mpflaga/biofeedback_2560_3V-eagle/biofeedback_2560_3V.pdf

# GND0.1uF

# 0R00.1uF

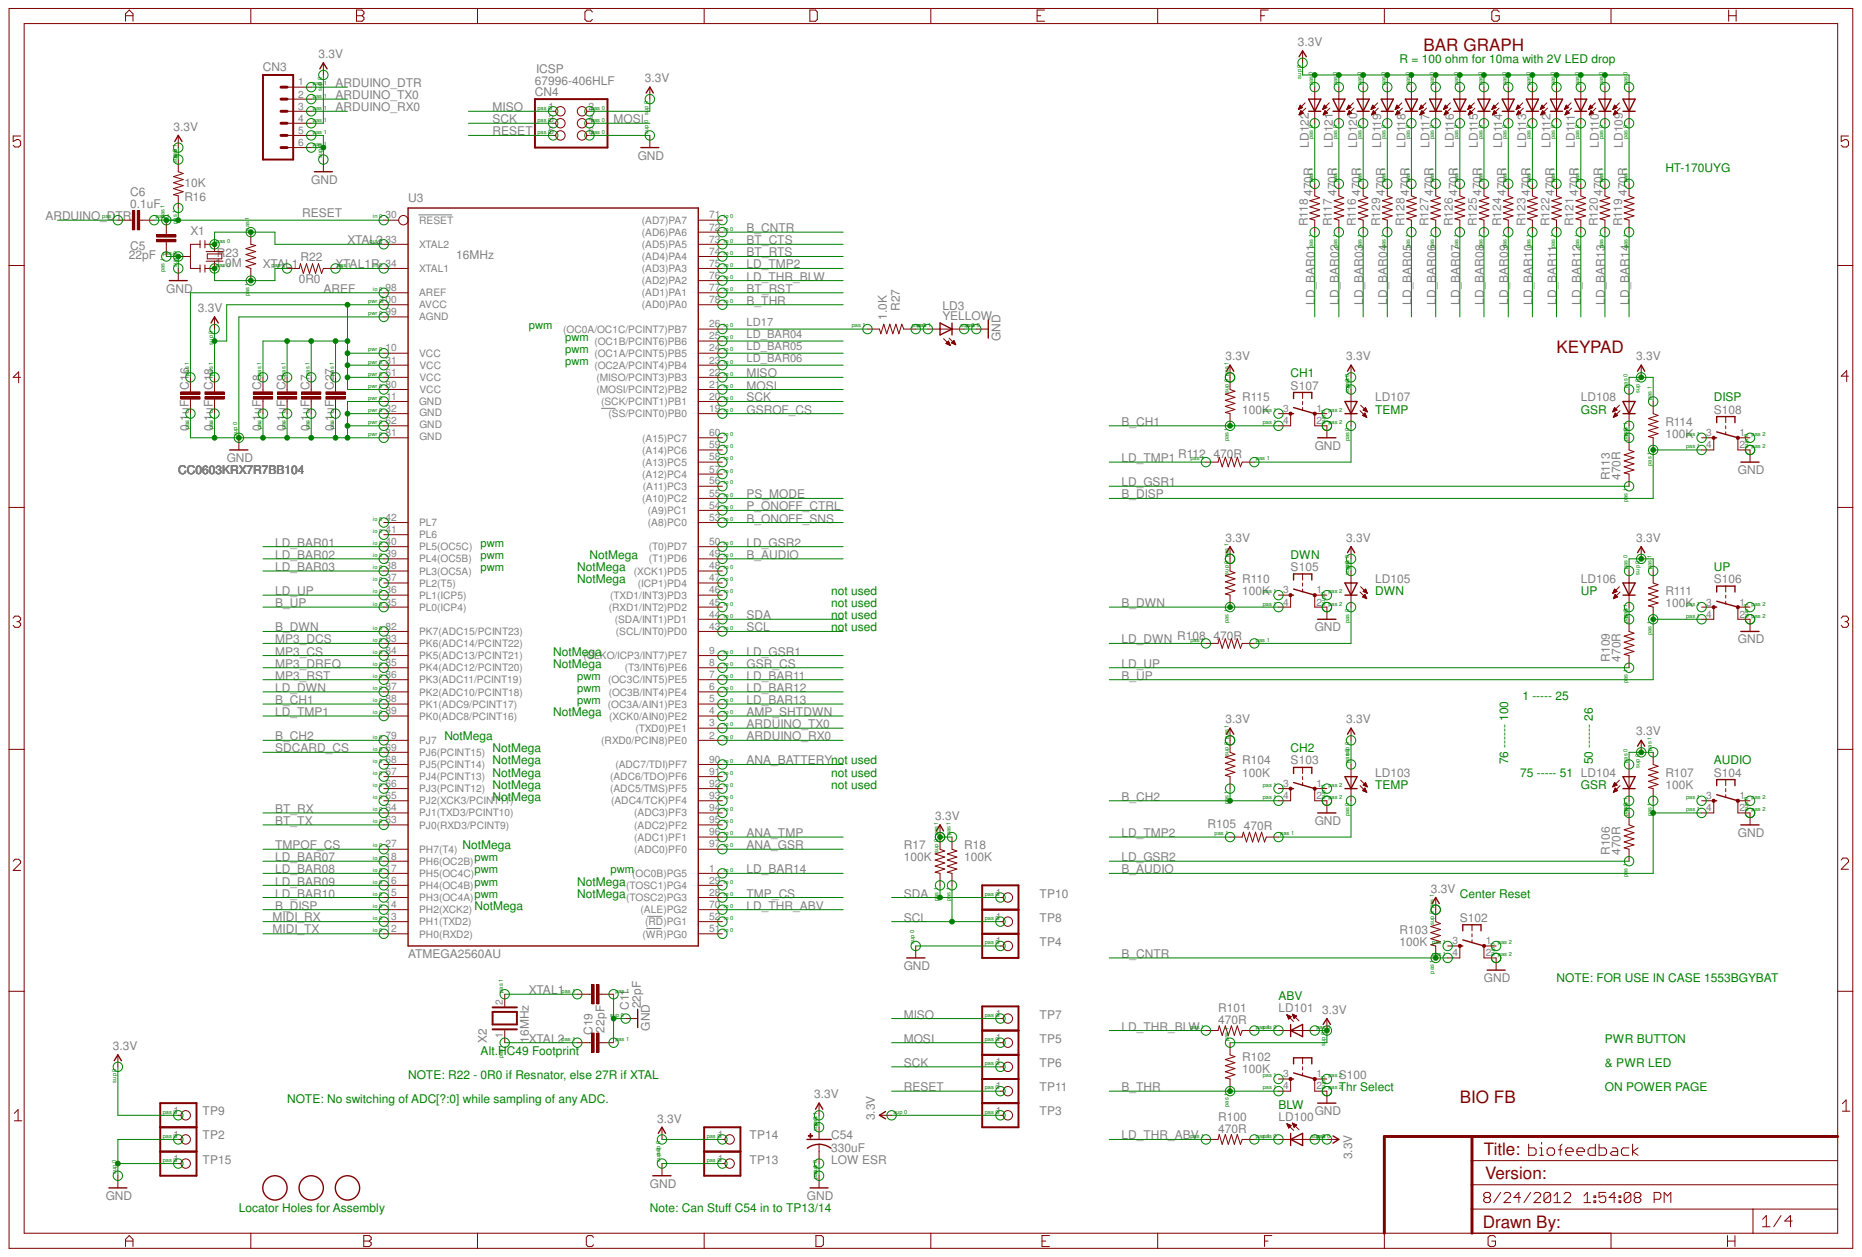
[picture p1: page 1]

BAR GRAPH
R = 100 ohm for 10ma with 2V LED drop

pas 0 pas 0 pas 1 pas 1

pwr 0 | AGND 99

pwr 0 | VCC 10

pas 1 pas 1 pas 1 pas 1

pas 1 pas 1

NOTE: FOR USE IN CASE 1553BGYBAT

NOTE: R22 - 0R0 if Resnator, else 27R if XTAL

NOTE: No switching of ADC[?:0] while sampling of any ADC.

Locator Holes for Assembly

Note: Can Stuff C54 in to TP13/14

## AUDIO AMPLIFIER

## LINE INPUT

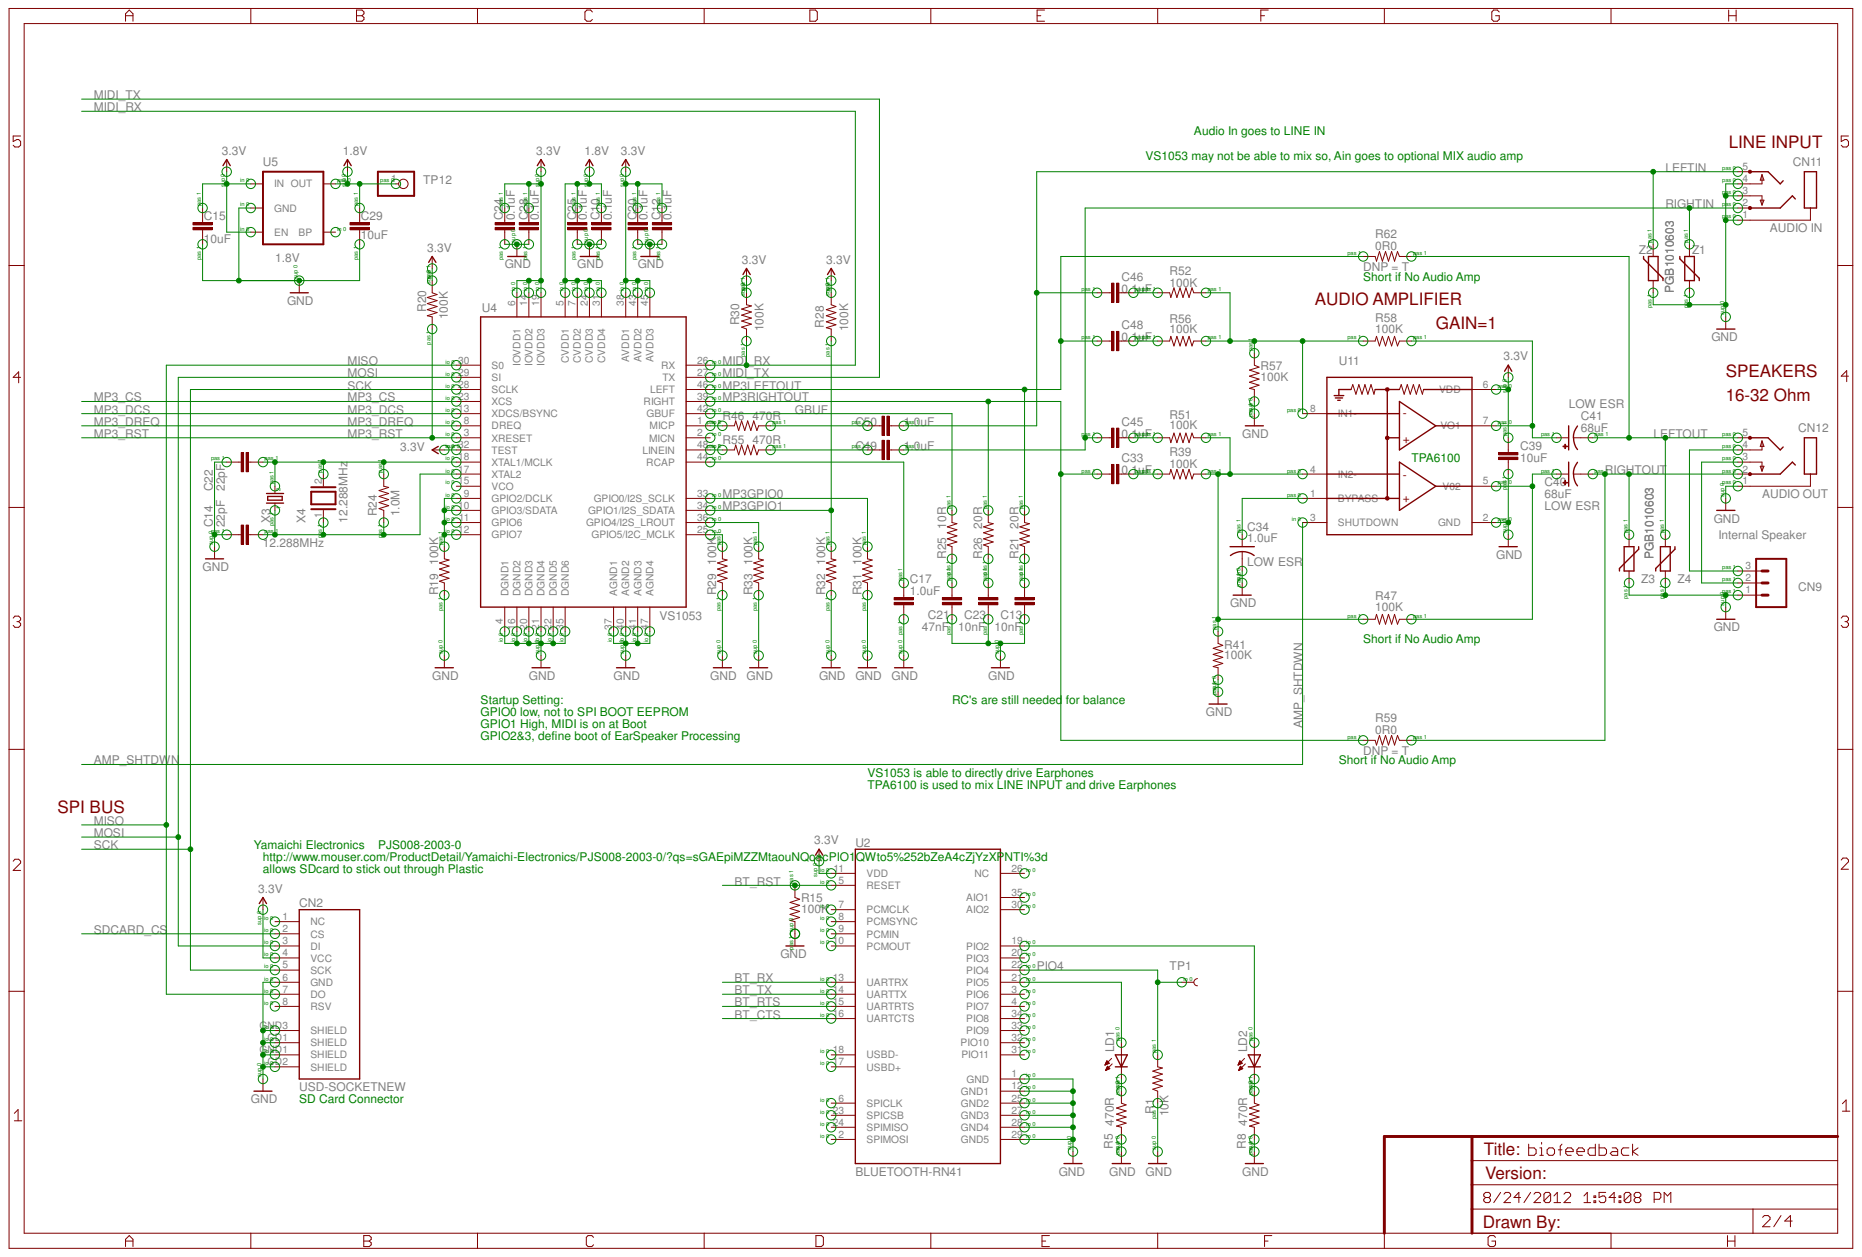
[picture p2: page 2]

Audio In goes to LINE IN

VS1053 may not be able to mix so, Ain goes to optional MIX audio amp

Short if No Audio Amp

Startup Setting:
GPIO0 low, not to SPI BOOT EEPROM
GPIO1 High, MIDI is on at Boot
GPIO2&3, define boot of EarSpeaker Processing

RC's are still needed for balance

VS1053 is able to directly drive Earphones
TPA6100 is used to mix LINE INPUT and drive Earphones

Yamaichi Electronics PJS008-2003-0
http://www.mouser.com/ProductDetail/Yamaichi-Electronics/PJS008-2003-0/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
allows SDcard to stick out through Plastic

## EXTERNAL

## GSR RESISTANCE

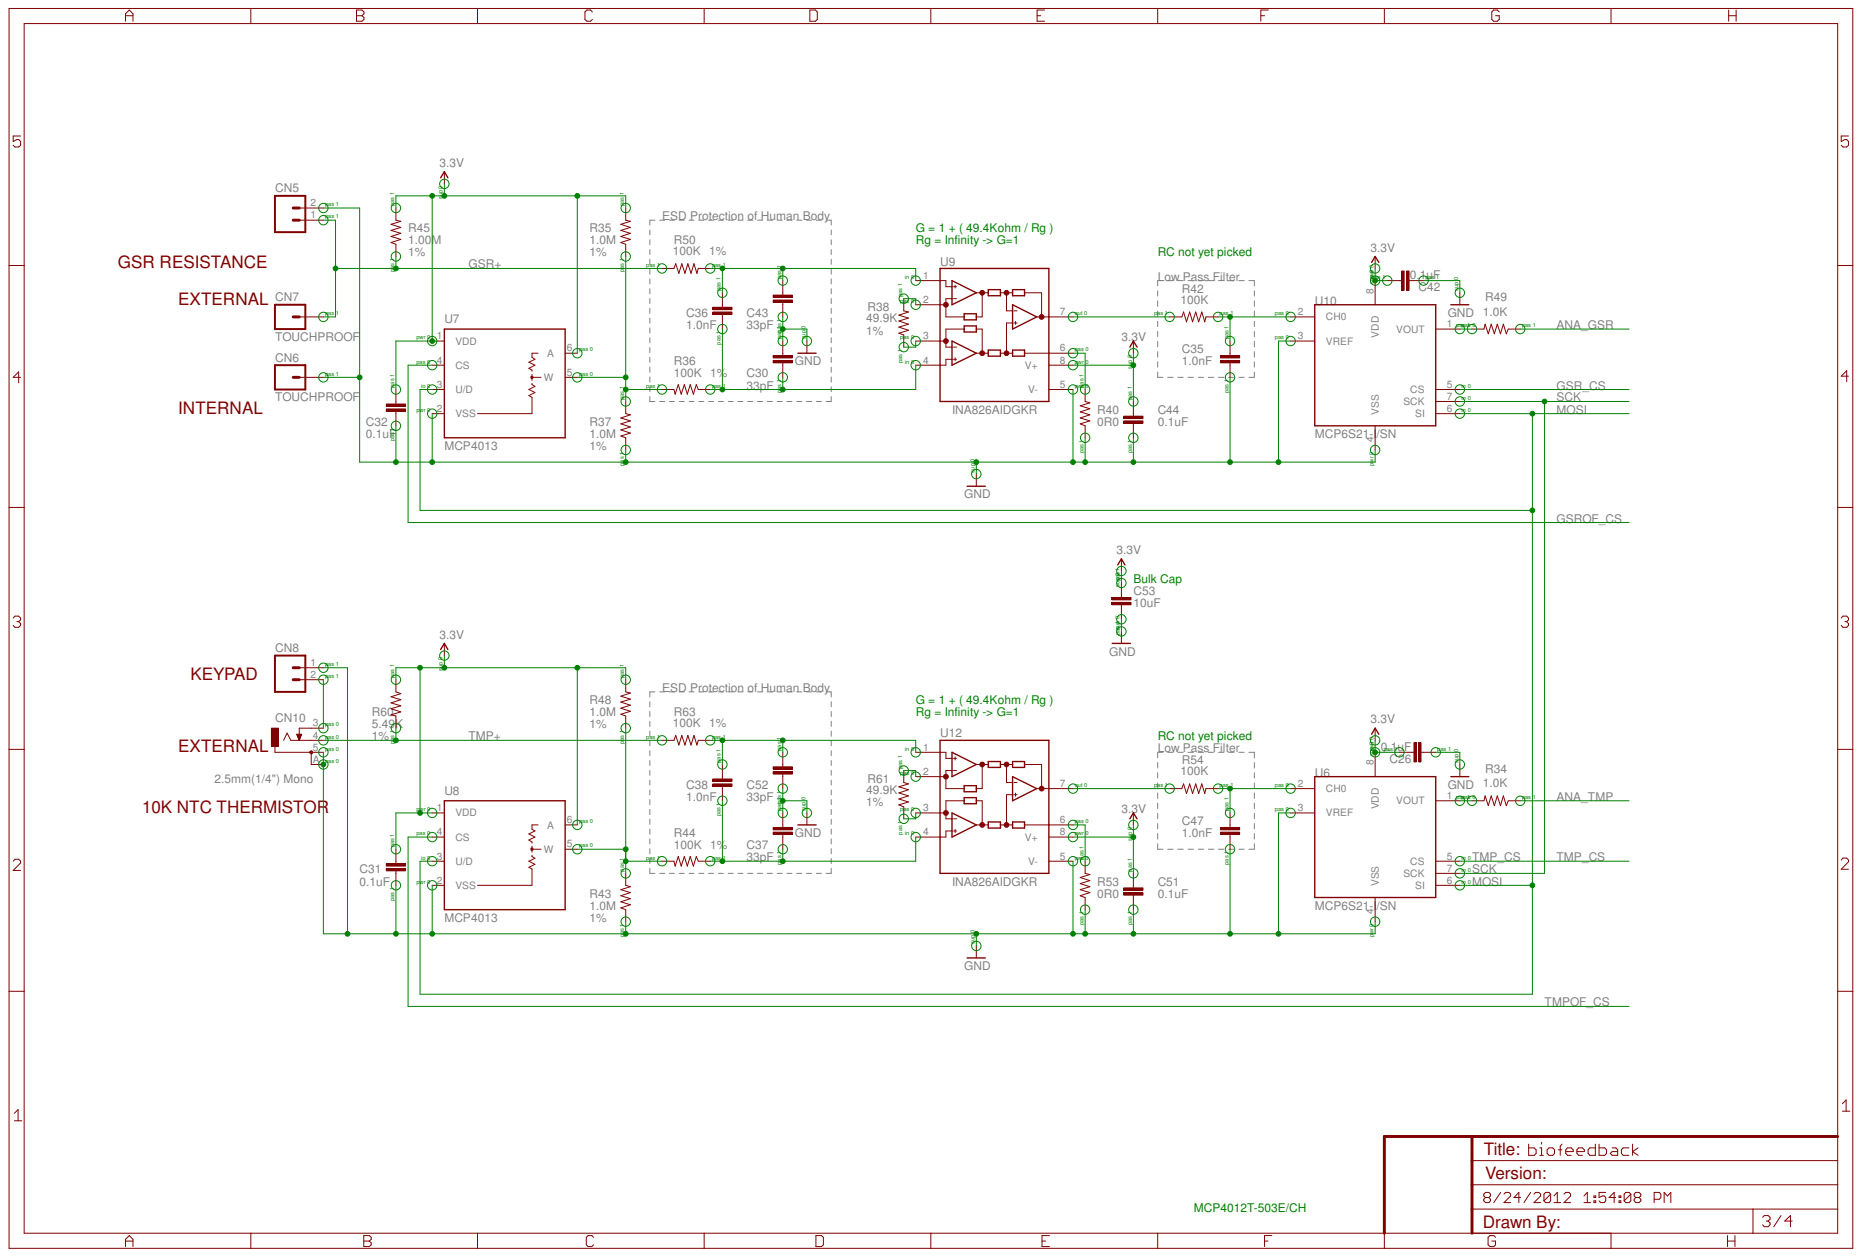
[picture p3: page 3]

pas 1 pas 1

ESD Protection of Human Body

RC not yet picked

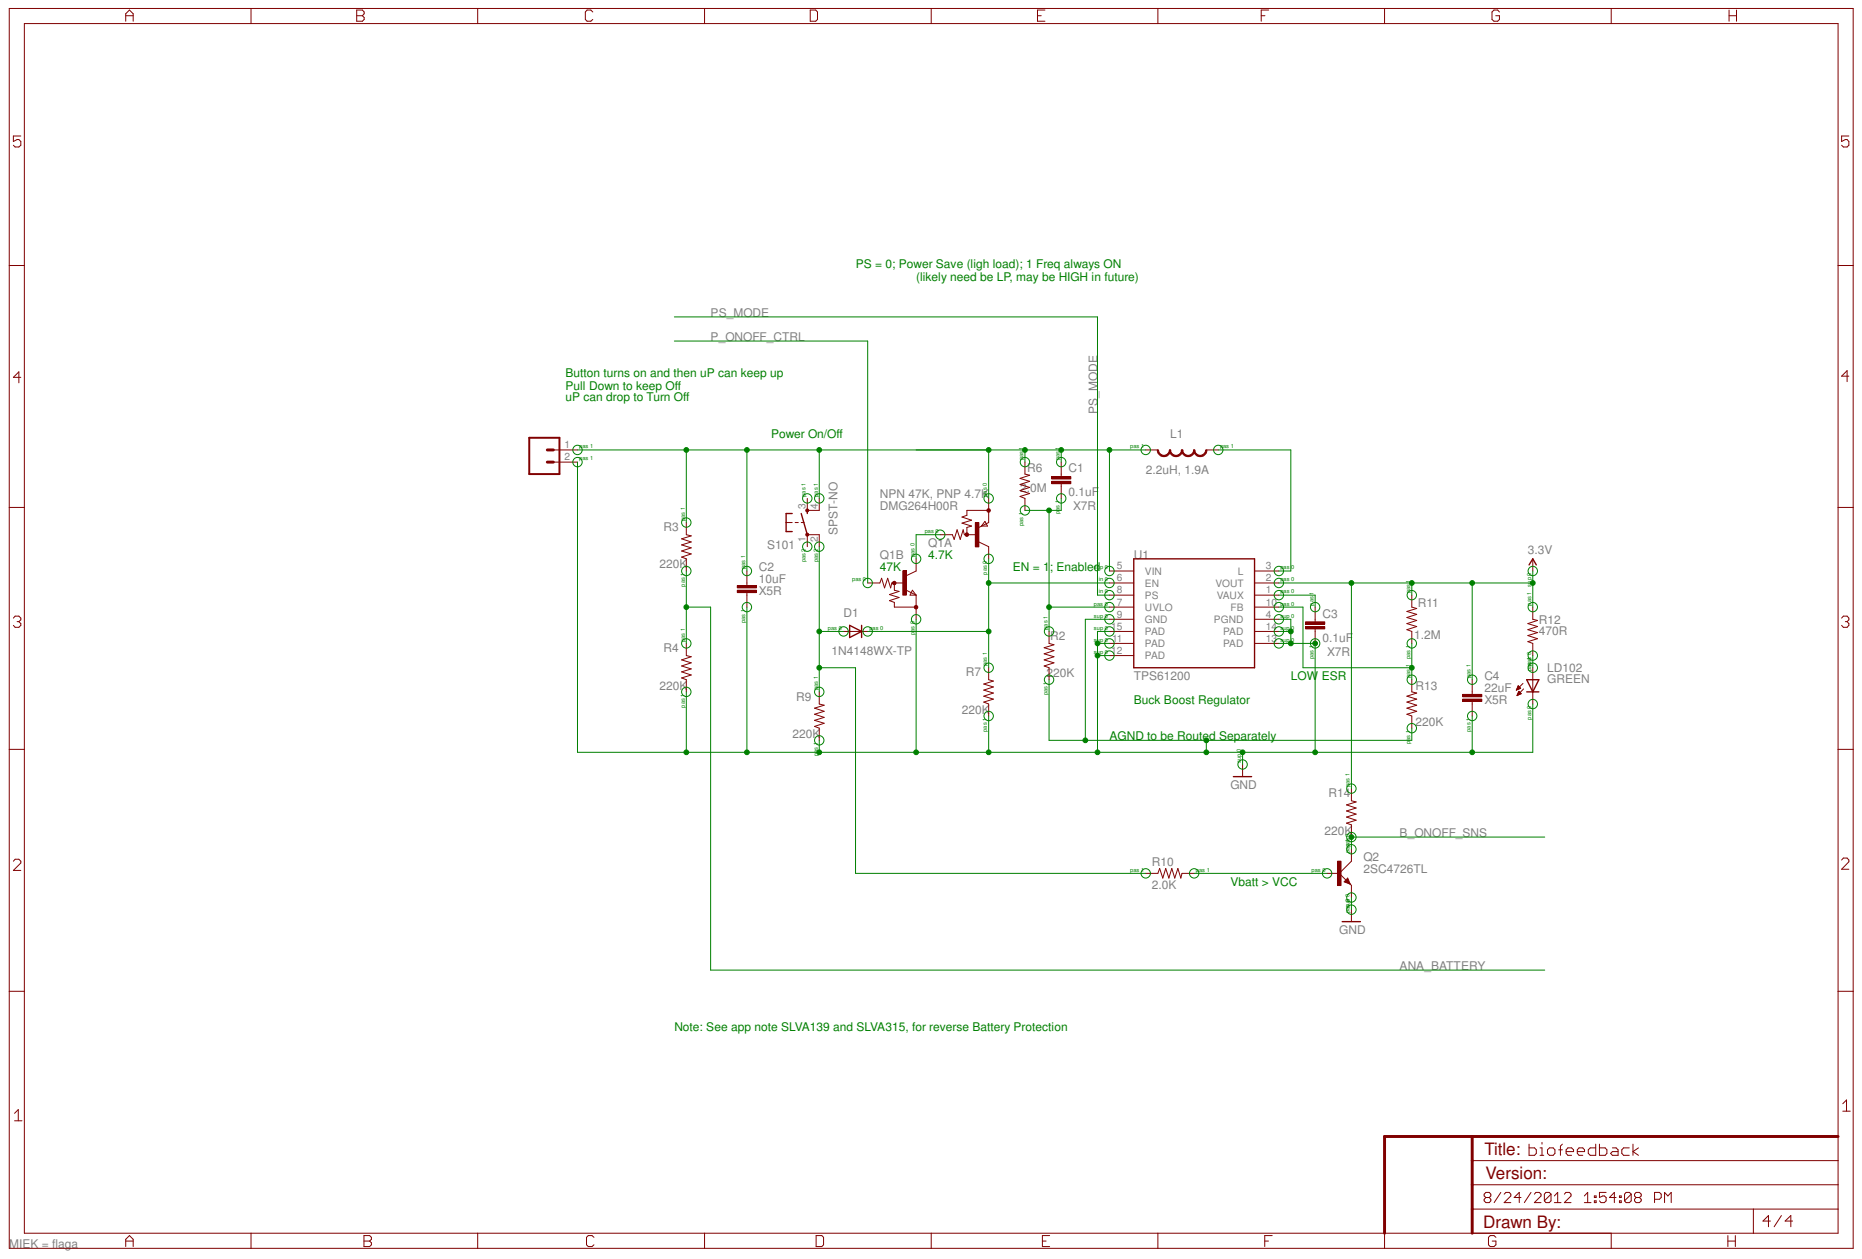
[picture p4: page 4]

PS = 0; Power Save (ligh load); 1 Freq always ON

(likely need be LP, may be HIGH in future)

Button turns on and then uP can keep up
Pull Down to keep Off
uP can drop to Turn Off

pas 1 pas 1

sup 0 | GND 9 | sup 0
sup 0 | PAD 15 | sup 0
sup 0 | PAD 11 | sup 0

AGND to be Routed Separately

pas 0 pas 0 sup 0 pas 1 pas 1

Note: See app note SLVA139 and SLVA315, for reverse Battery Protection
