mpflaga/biofeedback_2560_3V-eagle/biofeedback_2560_3V.brd

## EAGLE design biofeedback_2560_3V.brd (2012-07-17)

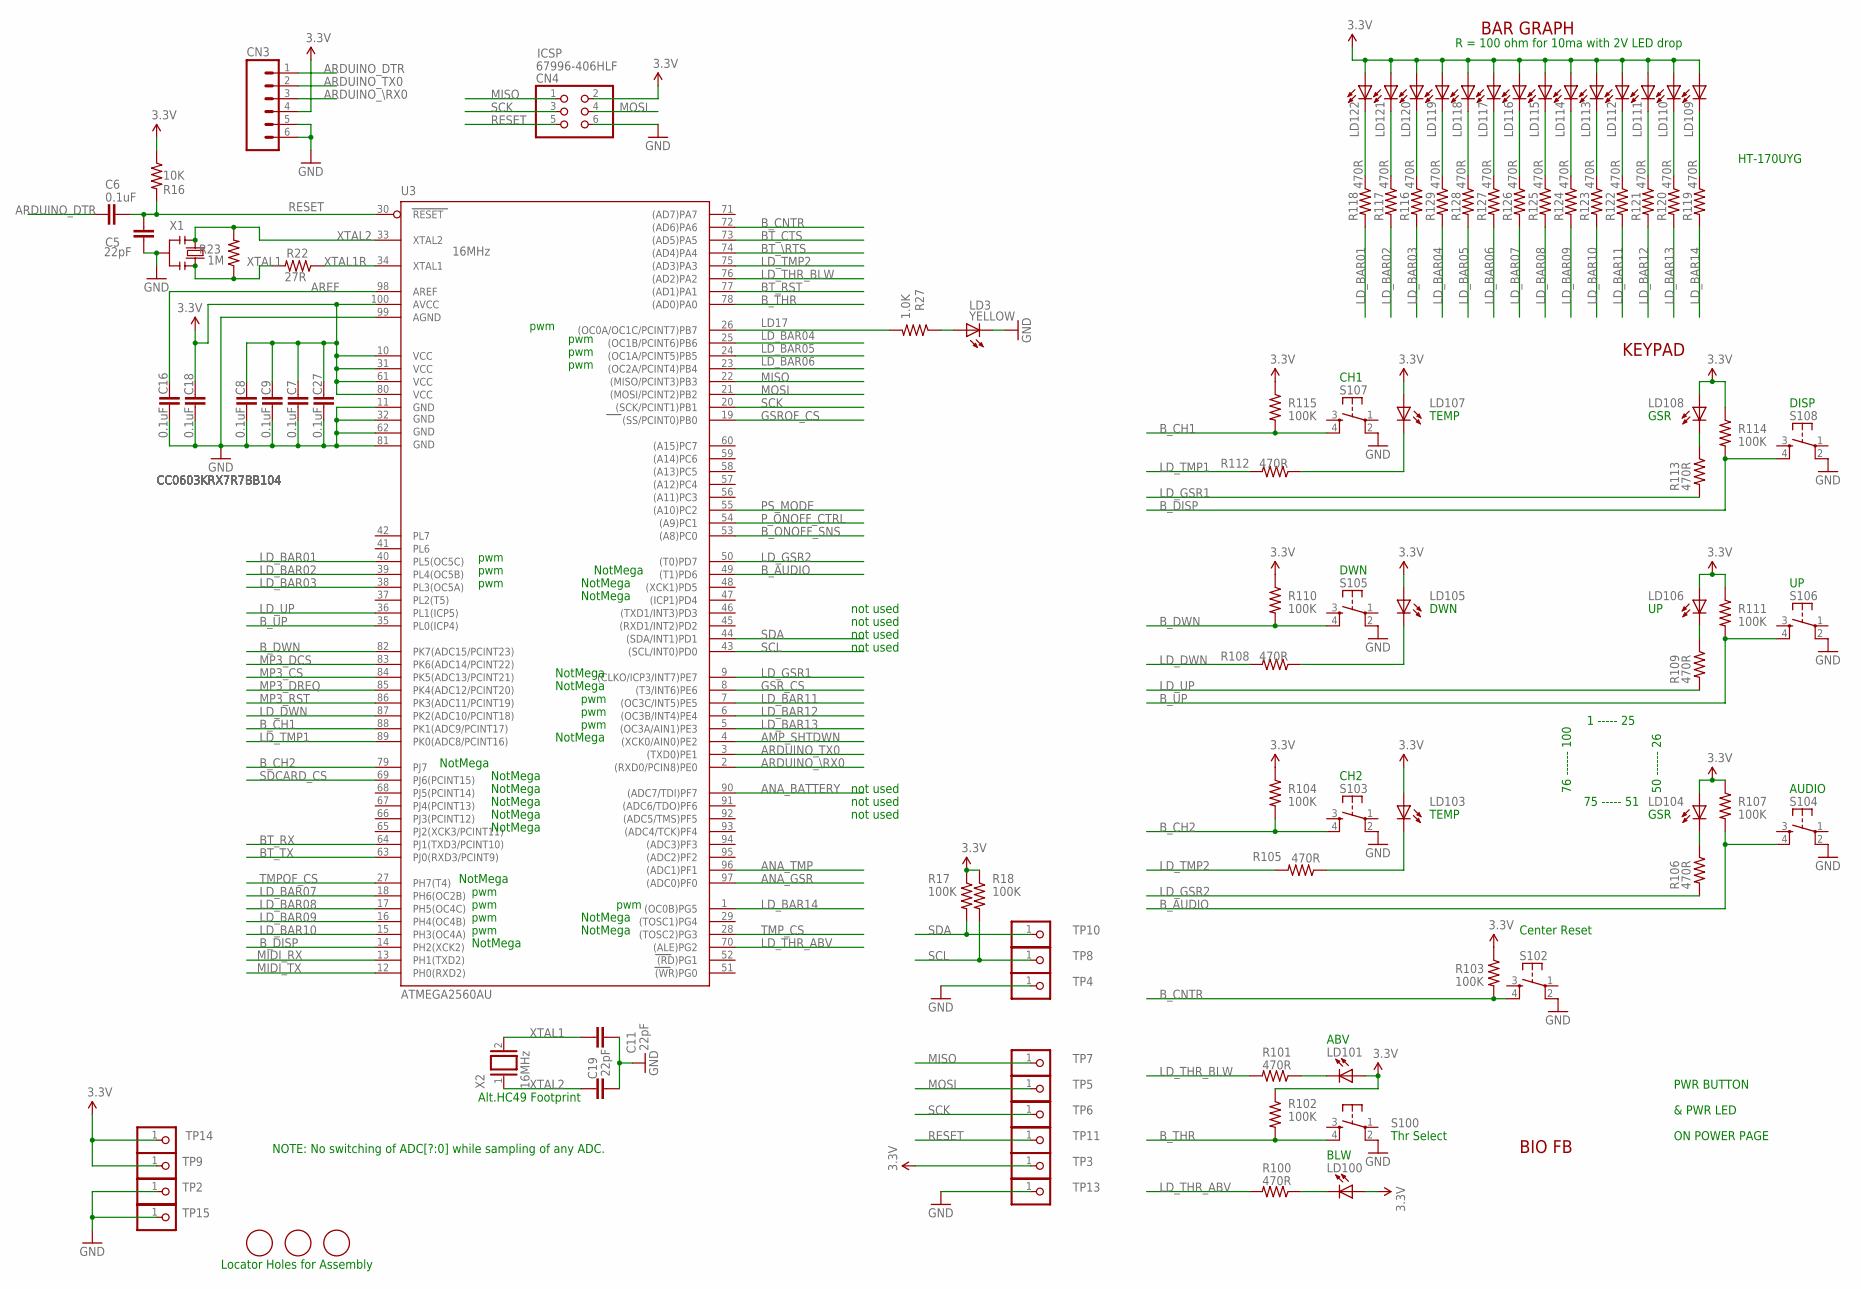
[picture p5: schematic biofeedback_2560_3V.sch, sheet 1]

Parts:
C5, C11, C19: 22pF; C0603; PARTNO GRM0335C1E220JD01D
C6, C7, C8, C9, C16, C18, C27: 0.1uF; C0603; PARTNO CC0603KRX7R7BB104
CN3: NSTUFF; 1X06; PARTNO 640456-6
CN4: ICSP; 2X03; PARTNO 67996-406HLF
LD3: YELLOW; CHIP-LED0805; PARTNO APT2012YC
LD100, LD101, LD103, LD104, LD105, LD106, LD107, LD108, LD109, LD110, LD111, LD112, LD113, LD114, LD115, LD116, LD117, LD118, LD119, LD120, LD121, LD122: GREEN; CHIP-LED0805; PARTNO LG R971-KN-1-0-20-R18
MN1, MN2, MN3: FIDUCIALMOUNT; FIDUCIA-MOUNT
R16: 10K; R0603; PARTNO RC0603JR-0710KL
R17, R18, R102, R103, R104, R107, R110, R111, R114, R115: 100K; R0603; PARTNO RC0603JR-07100KL
R22: 27R; R0603; PARTNO ERJ-3EKF27R0V
R23: 1M; R0603; PARTNO RC0603JR-071ML
R27: 1.0K; R0603; PARTNO RC0603JR-071KL
R100, R101, R105, R106, R108, R109, R112, R113, R116, R117, R118, R119, R120, R121, R122, R123, R124, R125, R126, R127, R128, R129: 470R; R0603; PARTNO RC0603JR-07470RL
S100, S102, S103, S104, S105, S106, S107, S108: SPST-NO; TACTILE_SWITCH_SMD_6MM_SQ; PARTNO TL3301PF160QG
TP2, TP3, TP4, TP5, TP6, TP7, TP8, TP9, TP10, TP11, TP13, TP14, TP15: NSTUFF; 1X01
U3: ATMEGA2560AU; TQFP100; PARTNO ATMEGA2560-16AU
X1: 16MHz; RESONATOR; PARTNO AWSCR-16.00CV-T
X2: 16MHz; QS; PARTNO ATS16B

Connections:
3.3V: C7.2, C8.2, C9.2, C18.2, C27.2, CN3.4, CN4.2, LD100.A, LD101.A, LD103.A, LD104.A, LD105.A, LD106.A, LD107.A, LD108.A, LD109.A, LD110.A, LD111.A, LD112.A, LD113.A, LD114.A, LD115.A, LD116.A, LD117.A, LD118.A, LD119.A, LD120.A, LD121.A, LD122.A, R16.1, R17.1, R18.1, R102.1, R103.1, R104.1, R107.1, R110.1, R111.1, R114.1, R115.1, TP3.1, TP9.1, TP14.1, U3.10 (VCC), U3.31 (VCC1), U3.61 (VCC2), U3.80 (VCC3), U3.100 (AVCC); also elsewhere on the board
AMP_SHTDWN: U3.4 ((XCK0/AIN0)PE2); also elsewhere on the board
ANA_BATTERY: U3.90 ((ADC7/TDI)PF7); also elsewhere on the board
ANA_GSR: U3.97 ((ADC0)PF0); also elsewhere on the board
ANA_TMP: U3.96 ((ADC1)PF1); also elsewhere on the board
ARDUINO_DTR: C6.1, CN3.1
ARDUINO_TX0: CN3.2, U3.3 ((TXD0)PE1)
ARDUINO_\RX0: CN3.3, U3.2 ((RXD0/PCIN8)PE0)
AREF: C16.2, U3.98 (AREF)
BT_CTS: U3.73 ((AD5)PA5); also elsewhere on the board
BT_RST: U3.77 ((AD1)PA1); also elsewhere on the board
BT_RX: U3.64 (PJ1(TXD3/PCINT10)); also elsewhere on the board
BT_TX: U3.63 (PJ0(RXD3/PCINT9)); also elsewhere on the board
BT_\RTS: U3.74 ((AD4)PA4); also elsewhere on the board
B_AUDIO: R107.2, S104.4, U3.49 ((T1)PD6)
B_CH1: R115.2, S107.4, U3.88 (PK1(ADC9/PCINT17))
B_CH2: R104.2, S103.4, U3.79 (PJ7)
B_CNTR: R103.2, S102.4, U3.72 ((AD6)PA6)
B_DISP: R114.2, S108.4, U3.14 (PH2(XCK2))
B_DWN: R110.2, S105.4, U3.82 (PK7(ADC15/PCINT23))
B_ONOFF_SNS: U3.53 ((A8)PC0); also elsewhere on the board
B_THR: R102.2, S100.4, U3.78 ((AD0)PA0)
B_UP: R111.2, S106.4, U3.35 (PL0(ICP4))
G2: LD107.C, R112.1
GND: C5.2, C7.1, C8.1, C9.1, C11.1, C16.1, C18.1, C19.1, C27.1, CN3.5, CN3.6, CN4.6, LD3.C, S100.2, S102.2, S103.2, S104.2, S105.2, S106.2, S107.2, S108.2, TP2.1, TP4.1, TP13.1, TP15.1, U3.11 (GND), U3.32 (GND1), U3.62 (GND2), U3.81 (GND3), U3.99 (AGND), X1.2; also elsewhere on the board
GSROF_CS: U3.19 ((SS/PCINT0)PB0); also elsewhere on the board
GSR_CS: U3.8 ((T3/INT6)PE6); also elsewhere on the board
LD17: R27.2, U3.26 ((OC0A/OC1C/PCINT7)PB7)
LD_BAR01: R118.2, U3.40 (PL5(OC5C))
LD_BAR02: R117.2, U3.39 (PL4(OC5B))
LD_BAR03: R116.2, U3.38 (PL3(OC5A))
LD_BAR04: R129.2, U3.25 ((OC1B/PCINT6)PB6)
LD_BAR05: R128.2, U3.24 ((OC1A/PCINT5)PB5)
LD_BAR06: R127.2, U3.23 ((OC2A/PCINT4)PB4)
LD_BAR07: R126.2, U3.18 (PH6(OC2B))
LD_BAR08: R125.2, U3.17 (PH5(OC4C))
LD_BAR09: R124.2, U3.16 (PH4(OC4B))
LD_BAR10: R123.2, U3.15 (PH3(OC4A))
LD_BAR11: R122.2, U3.7 ((OC3C/INT5)PE5)
LD_BAR12: R121.2, U3.6 ((OC3B/INT4)PE4)
LD_BAR13: R120.2, U3.5 ((OC3A/AIN1)PE3)
LD_BAR14: R119.2, U3.1 ((OC0B)PG5)
LD_DWN: R108.2, U3.87 (PK2(ADC10/PCINT18))
LD_GSR1: R113.2, U3.9 ((CLKO/ICP3/INT7)PE7)
LD_GSR2: R106.2, U3.50 ((T0)PD7)
LD_THR_ABV: R100.2, U3.70 ((ALE)PG2)
LD_THR_BLW: R101.2, U3.76 ((AD2)PA2)
LD_TMP1: R112.2, U3.89 (PK0(ADC8/PCINT16))
LD_TMP2: R105.2, U3.75 ((AD3)PA3)
LD_UP: R109.2, U3.36 (PL1(ICP5))
MIDI_RX: U3.13 (PH1(TXD2)); also elsewhere on the board
MIDI_TX: U3.12 (PH0(RXD2)); also elsewhere on the board
MISO: CN4.1, TP7.1, U3.22 ((MISO/PCINT3)PB3); also elsewhere on the board
MOSI: CN4.4, TP5.1, U3.21 ((MOSI/PCINT2)PB2); also elsewhere on the board
MP3_CS: U3.84 (PK5(ADC13/PCINT21)); also elsewhere on the board
MP3_DCS: U3.83 (PK6(ADC14/PCINT22)); also elsewhere on the board
MP3_DREQ: U3.85 (PK4(ADC12/PCINT20)); also elsewhere on the board
MP3_RST: U3.86 (PK3(ADC11/PCINT19)); also elsewhere on the board
unnamed: LD105.C, R108.1
unnamed: LD106.C, R109.1
unnamed: LD122.C, R118.1
unnamed: LD121.C, R117.1
unnamed: LD120.C, R116.1
unnamed: LD119.C, R129.1
unnamed: LD118.C, R128.1
unnamed: LD117.C, R127.1
unnamed: LD116.C, R126.1
unnamed: LD115.C, R125.1
unnamed: LD114.C, R124.1
unnamed: LD113.C, R123.1
unnamed: LD112.C, R122.1
unnamed: LD111.C, R121.1
unnamed: LD110.C, R120.1
unnamed: LD109.C, R119.1
unnamed: LD103.C, R105.1
unnamed: LD104.C, R106.1
unnamed: LD101.C, R101.1
unnamed: LD100.C, R100.1
unnamed: LD108.C, R113.1
unnamed: LD3.A, R27.1
PS_MODE: U3.55 ((A10)PC2); also elsewhere on the board
P_ONOFF_CTRL: U3.54 ((A9)PC1); also elsewhere on the board
RESET: C5.1, C6.2, CN4.5, R16.2, TP11.1, U3.30 (RESET)
SCK: CN4.3, TP6.1, U3.20 ((SCK/PCINT1)PB1); also elsewhere on the board
SCL: R18.2, TP8.1, U3.43 ((SCL/INT0)PD0)
SDA: R17.2, TP10.1, U3.44 ((SDA/INT1)PD1)
SDCARD_CS: U3.69 (PJ6(PCINT15)); also elsewhere on the board
TMPOF_CS: U3.27 (PH7(T4)); also elsewhere on the board
TMP_CS: U3.28 ((TOSC2)PG3); also elsewhere on the board
XTAL1: C11.2, R22.2, R23.1, X1.3, X2.2
XTAL1R: R22.1, U3.34 (XTAL1)
XTAL2: C19.2, R23.2, U3.33 (XTAL2), X1.1, X2.1

Notes on the sheet:
Alt.HC49 Footprint
BIO FB
pwm
NOTE: No switching of ADC[?:0] while sampling of any ADC.
BAR GRAPH
CH1
ABV
BLW
DISP
DWN
Thr Select
Center Reset
KEYPAD
CH2
AUDIO
TEMP
PWR BUTTON
& PWR LED
ON POWER PAGE
Locator Holes for Assembly
not used
NotMega
GSR
R = 100 ohm for 10ma with 2V LED drop
HT-170UYG
1 ----- 25
75 ----- 51
50 ------ 26
76 ------ 100

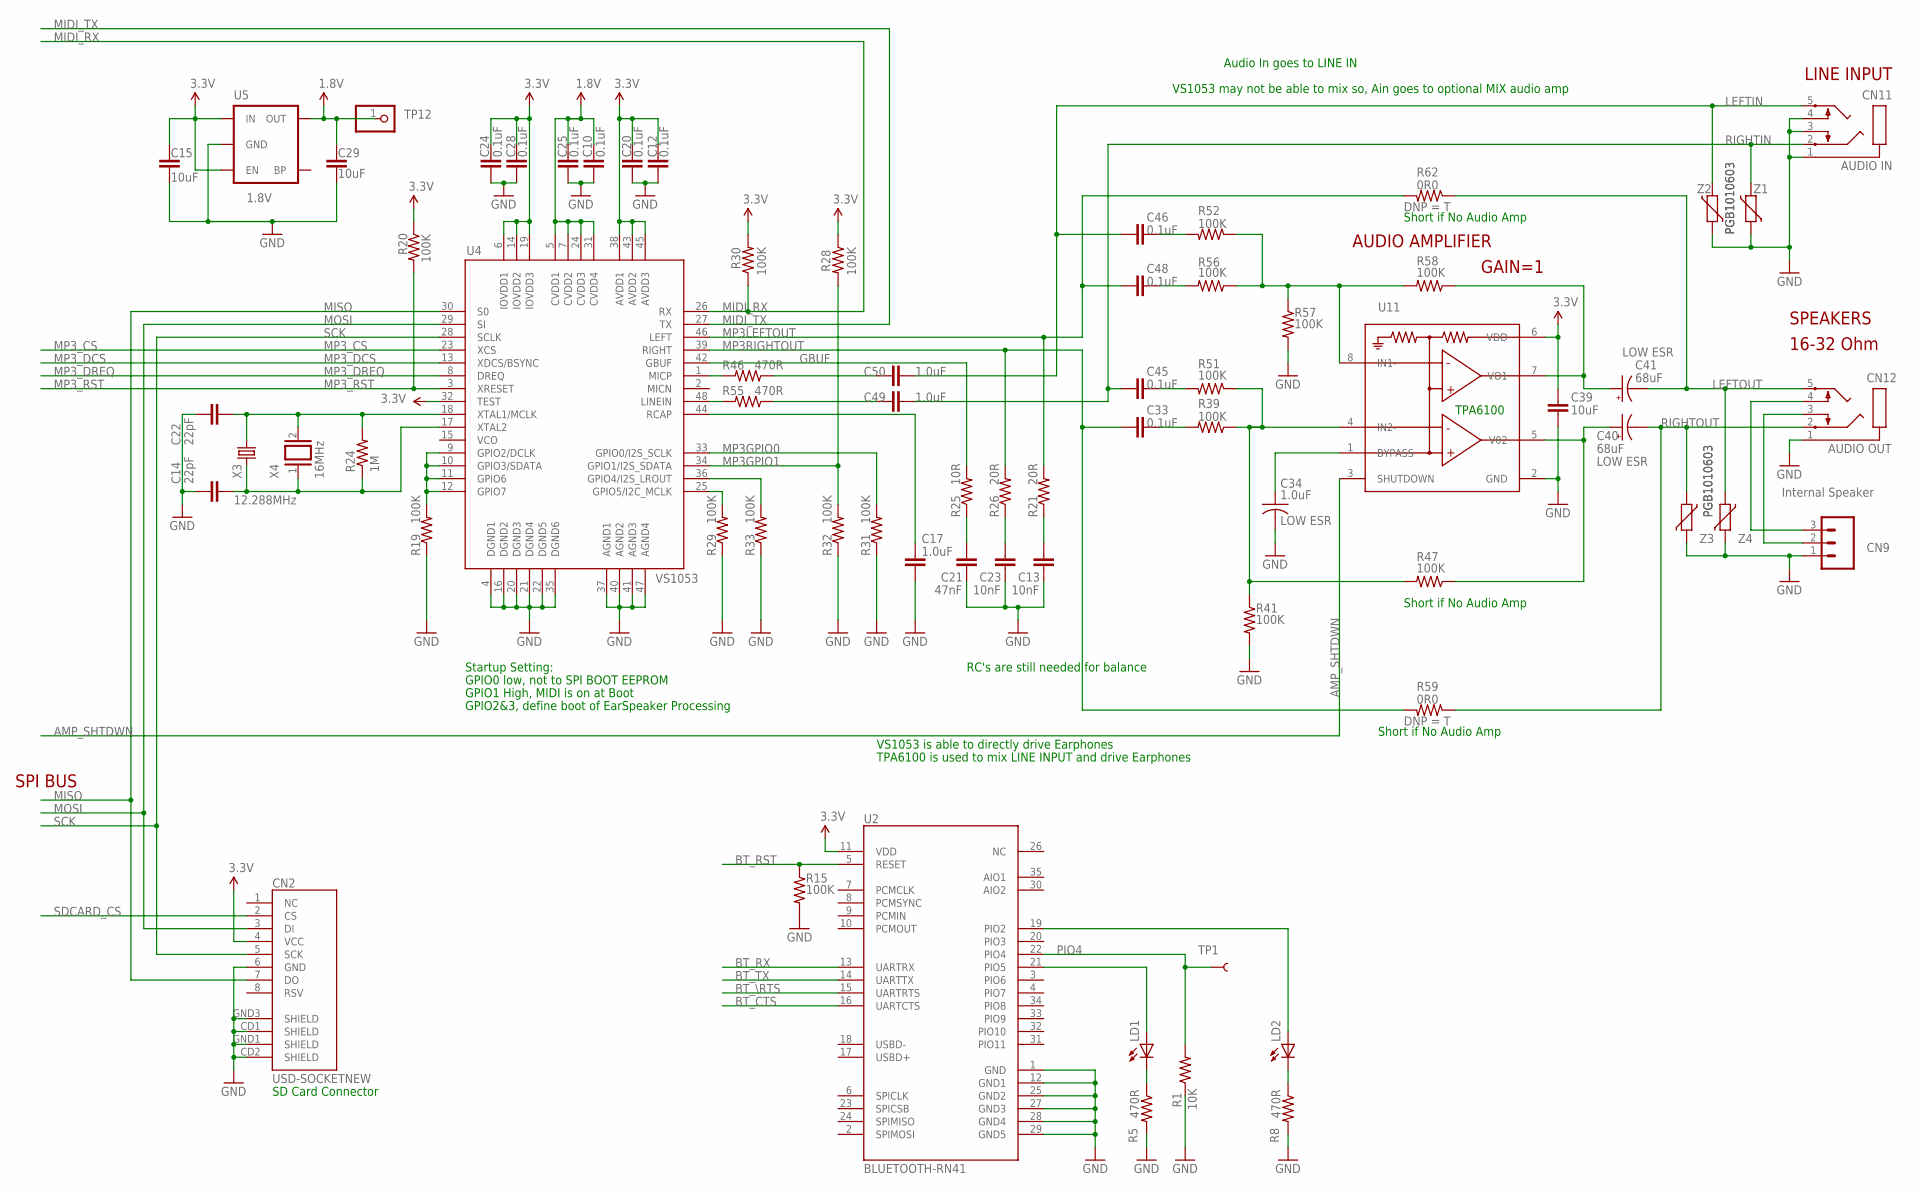
[picture p6: schematic biofeedback_2560_3V.sch, sheet 2]

Parts:
C10, C12, C20, C24, C25, C28, C33, C45, C46, C48: 0.1uF; C0603; PARTNO CC0603KRX7R7BB104
C13, C23: 10nF; C0603; PARTNO CC0603KRX7R9BB103
C14, C22: 22pF; C0603; PARTNO GRM0335C1E220JD01D
C15, C29, C39: 10uF; C0603; PARTNO C1608X5R1A106M
C17, C49, C50: 1.0uF; C0603; PARTNO GRM188R61A105KA61D
C21: 47nF; C0603; PARTNO CC0603KRX7R8BB473
C34: 1.0uF; C0805; PARTNO ECP-U1C104MA5
C40, C41: 68uF; CT7343; PARTNO T491C686K006AT
CN2: USD-SOCKETNEW; MICRO-SD-SOCKET-PP; PARTNO 101-00581-59
CN9: Internal Speaker; 1X03; PARTNO 640454-3
CN11: AUDIO IN; STX3100; PARTNO SJ1-3555NG-BE
CN12: AUDIO OUT; STX3100; PARTNO SJ1-3555NG-GR
LD1, LD2: GREEN; CHIP-LED0805; PARTNO LG R971-KN-1-0-20-R18
R1: 10K; R0603; PARTNO RC0603JR-0710KL
R5, R8, R46, R55: 470R; R0603; PARTNO RC0603JR-07470RL
R15, R19, R20, R28, R29, R30, R31, R32, R33, R39, R41, R47, R51, R52, R56, R57, R58: 100K; R0603; PARTNO RC0603JR-07100KL
R21, R26: 20R; R0603; PARTNO RC0603JR-0720RL
R24: 1M; R0603; PARTNO RC0603JR-071ML
R25: 10R; R0603; PARTNO RC0603JR-0710RL
R59, R62: 0R0; R0603; PARTNO RC0603JR-070RL
TP1: TEST-POINT3X5; PAD.03X.05
TP12: NSTUFF; 1X01
U2: BLUETOOTH-RN41; RN41; PARTNO RN-42
U4: VS1053; LQFP-48; PARTNO VS1053B-L
U5: 1.8V; SC70; PARTNO MIC5365-1.8YC5
U11: TPA6100; SO-08; PARTNO TPA6100A2DR
X3: 12.288MHz; CRYSTAL-SMD-5X3; PARTNO ATS122B
X4: 16MHz; QS_COMBO; PARTNO ATS16B
Z1, Z2, Z3, Z4: PGB1010603; CT/CN0603; PARTNO PGB1010603MR

Connections:
1.8V: C10.1, C25.1, C29.1, TP12.1, U4.5 (CVDD1), U4.7 (CVDD2), U4.24 (CVDD3), U4.31 (CVDD4), U5.5 (OUT)
3.3V: C12.1, C15.1, C20.1, C24.1, C28.1, C39.1, CN2.4 (VCC), R20.1, R28.1, R30.2, U2.11 (VDD), U4.6 (IOVDD1), U4.14 (IOVDD2), U4.19 (IOVDD3), U4.32 (TEST), U4.38 (AVDD1), U4.43 (AVDD2), U4.45 (AVDD3), U5.1 (IN), U5.3 (EN), U11.6 (VDD); also elsewhere on the board
AMP_SHTDWN: U11.3 (SHUTDOWN); also elsewhere on the board
BT_CTS: U2.16 (UARTCTS); also elsewhere on the board
BT_RST: R15.1, U2.5 (RESET); also elsewhere on the board
BT_RX: U2.13 (UARTRX); also elsewhere on the board
BT_TX: U2.14 (UARTTX); also elsewhere on the board
BT_\RTS: U2.15 (UARTRTS); also elsewhere on the board
D1: LD1.C, R5.1
D2: LD2.C, R8.1
GBUF: R25.2, U4.42 (GBUF)
GND: C10.2, C12.2, C13.2, C14.1, C15.2, C17.1, C20.2, C21.2, C22.1, C23.2, C24.2, C25.2, C28.2, C29.2, C34.2, C39.2, CN2.6 (GND), CN2.CD1 (SHIELD), CN2.CD2 (SHIELD), CN2.GND1 (SHIELD), CN2.GND3 (SHIELD), CN9.1, CN11.1, CN11.3, CN11.4, CN12.1, R1.1, R5.2, R8.2, R15.2, R19.1, R29.1, R31.1, R32.1, R33.1, R41.2, R57.2, U2.1 (GND), U2.12 (GND1), U2.25 (GND2), U2.27 (GND3), U2.28 (GND4), U2.29 (GND5), U4.4 (DGND1), U4.16 (DGND2), U4.20 (DGND3), U4.21 (DGND4), U4.22 (DGND5), U4.35 (DGND6), U4.37 (AGND1), U4.40 (AGND2), U4.41 (AGND3), U4.47 (AGND4), U5.2 (GND), U11.2 (GND), Z1.2, Z2.2, Z3.2, Z4.2; also elsewhere on the board
LEFTIN: C46.1, C50.1, CN11.5, Z2.1
LEFTOUT: C41.-, CN12.5, R62.1, Z4.1
LEFTOUTSPKR: CN9.3, CN12.4
MIDI_RX: R30.1, U4.26 (RX); also elsewhere on the board
MIDI_TX: U4.27 (TX); also elsewhere on the board
MISO: CN2.7 (DO), U4.30 (S0); also elsewhere on the board
MOSI: CN2.3 (DI), U4.29 (SI); also elsewhere on the board
MP3GPIO0: R31.2, U4.33 (GPIO0/I2S_SCLK)
MP3GPIO1: R28.2, R32.2, U4.34 (GPIO1/I2S_SDATA)
MP3LEFTOUT: C48.1, R21.2, R62.2, U4.46 (LEFT)
MP3LINEINLEFT: R46.2, U4.1 (MICP)
MP3LINEINRIGHT: R55.2, U4.48 (LINEIN)
MP3RCAP: C17.2, U4.44 (RCAP)
MP3RIGHTOUT: C33.1, R26.2, R59.2, U4.39 (RIGHT)
MP3_CS: U4.23 (XCS); also elsewhere on the board
MP3_DCS: U4.13 (XDCS/BSYNC); also elsewhere on the board
MP3_DREQ: U4.8 (DREQ); also elsewhere on the board
MP3_RST: R20.2, U4.3 (XRESET); also elsewhere on the board
unnamed: R52.1, R56.1, R57.1, R58.2, U11.8 (IN1-)
unnamed: C21.1, R25.1
unnamed: C13.1, R21.1
unnamed: C46.2, R52.2
unnamed: C23.1, R26.1
unnamed: R39.1, R41.1, R47.2, R51.1, U11.4 (IN2-)
unnamed: C14.2, R24.1, U4.17 (XTAL2), X3.1, X4.1
unnamed: C45.2, R51.2
unnamed: C41.+, R58.1, U11.7 (VO1)
unnamed: C40.+, R47.1, U11.5 (V02)
unnamed: C48.2, R56.2
unnamed: C33.2, R39.2
unnamed: C34.1, U11.1 (BYPASS)
unnamed: LD1.A, U2.21 (PIO5)
unnamed: R19.2, U4.9 (GPIO2/DCLK), U4.10 (GPIO3/SDATA), U4.11 (GPIO6), U4.12 (GPIO7)
unnamed: LD2.A, U2.19 (PIO2)
unnamed: R33.2, U4.36 (GPIO4/I2S_LROUT)
unnamed: R29.2, U4.25 (GPIO5/I2C_MCLK)
unnamed: C50.2, R46.1
unnamed: C49.2, R55.1
unnamed: C22.2, R24.2, U4.18 (XTAL1/MCLK), X3.3 (2), X4.2
PIO4: R1.2, TP1.P$1, U2.22 (PIO4)
RIGHTIN: C45.1, C49.1, CN11.2, Z1.1
RIGHTOUT: C40.-, CN12.2, R59.1, Z3.1
RIGHTOUTSPKR: CN9.2, CN12.3
SCK: CN2.5 (SCK), U4.28 (SCLK); also elsewhere on the board
SDCARD_CS: CN2.2 (CS); also elsewhere on the board

Notes on the sheet:
GPIO0 low, not to SPI BOOT EEPROM
GPIO1 High, MIDI is on at Boot
GPIO2&3, define boot of EarSpeaker Processing
Startup Setting:
SD Card Connector
SPI BUS
AUDIO AMPLIFIER
LINE INPUT
16-32 Ohm
SPEAKERS
VS1053 is able to directly drive Earphones
TPA6100 is used to mix LINE INPUT and drive Earphones
RC's are still needed for balance
TPA6100
Short if No Audio Amp
GAIN=1
Audio In goes to LINE IN
VS1053 may not be able to mix so, Ain goes to optional MIX audio amp

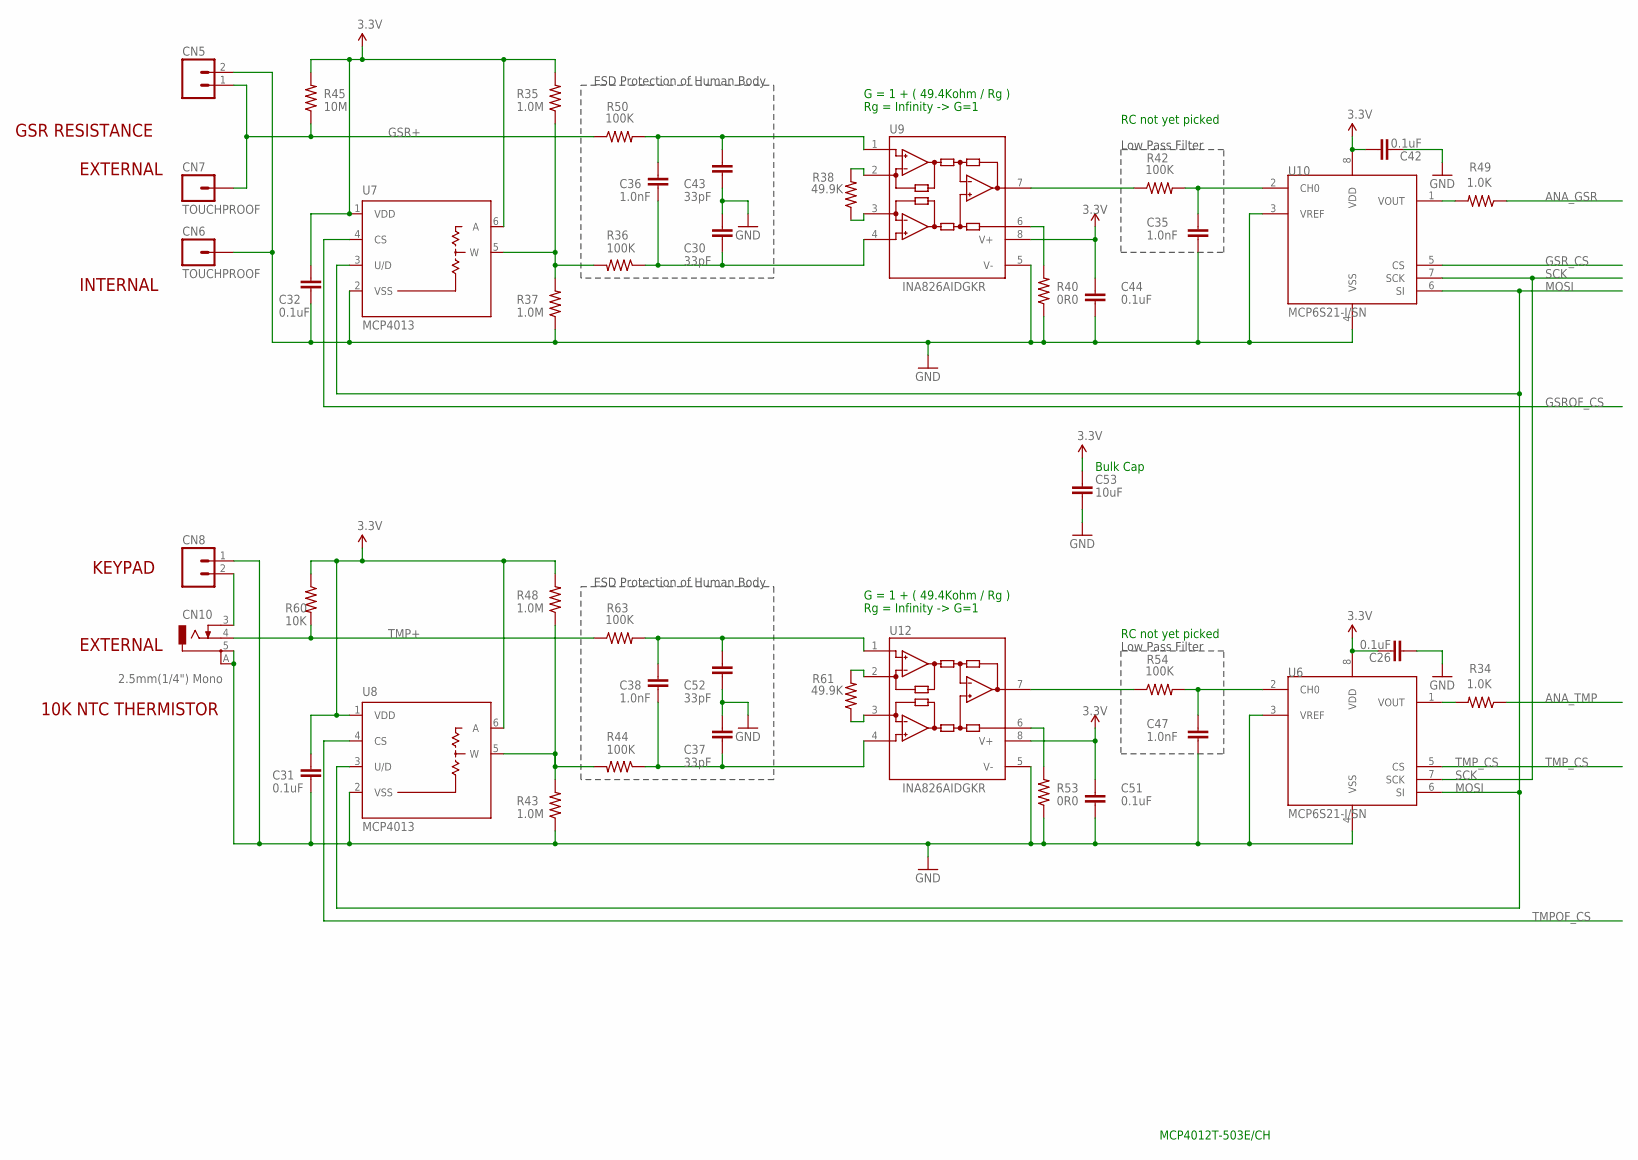
[picture p7: schematic biofeedback_2560_3V.sch, sheet 3]

Parts:
C26, C31, C32, C42, C44, C51: 0.1uF; C0603; PARTNO CC0603KRX7R7BB104
C30, C37, C43, C52: 33pF; C0603; PARTNO GRM0335C1E330JD01D
C35, C36, C38, C47: 1.0nF; C0603; PARTNO CC0603KRX7R9BB102
C53: 10uF; C0603; PARTNO C1608X5R1A106M
CN5, CN8: CONN HEADER PH TOP 2POS 2MM; 1X02; PARTNO B2B-PH-K-S(LF)(SN)
CN6, CN7: TOUCHPROOF; TOUCHPROOF1.1MM; PARTNO 36619
CN10: 2.5mm(1/4") Mono; STEREOJACK2.5MM_SMD; PARTNO MDSMT2ARATRX
R34, R49: 1.0K; R0603; PARTNO RC0603JR-071KL
R35, R37, R43, R48: 1.0M; R0603; PARTNO RC0603JR-071ML
R36, R42, R44, R50, R54, R63: 100K; R0603; PARTNO RC0603JR-07100KL
R38, R61: 49.9K; R0603; PARTNO ERJ-3EKF4992V
R40, R53: 0R0; R0603; PARTNO RC0603JR-070RL
R45: 10M; R0603; PARTNO RC0603JR-0710ML
R60: 10K; R0603; PARTNO RC0603JR-0710KL
U6, U10: MCP6S21-I/SN; SO-08; PARTNO MCP6S21-I/SN
U7, U8: MCP4013; SOT-23-6; PARTNO MCP4013T-103E/CH
U9, U12: INA826; MSOP-8; PARTNO INA826AIDGKR

Connections:
3.3V: C26.1, C31.1, C32.1, C42.1, C44.1, C51.1, C53.1, R35.2, R45.2, R48.2, R60.1, U6.8 (VDD), U7.1 (VDD), U7.6 (A), U8.1 (VDD), U8.6 (A), U9.8 (V+), U10.8 (VDD), U12.8 (V+); also elsewhere on the board
ANA_GSR: R49.1; also elsewhere on the board
ANA_TMP: R34.1; also elsewhere on the board
GND: C26.2, C30.1, C31.2, C32.2, C35.2, C37.1, C42.2, C43.2, C44.2, C47.2, C51.2, C52.2, C53.2, CN5.2, CN6.P$1, CN8.1, CN10.5, CN10.A, R37.1, R40.1, R43.1, R53.1, U6.3 (VREF), U6.4 (VSS), U7.2 (VSS), U8.2 (VSS), U9.5 (V-), U10.3 (VREF), U10.4 (VSS), U12.5 (V-); also elsewhere on the board
GSR+: CN5.1, CN7.P$1, R45.1, R50.1
GSROF_CS: U7.4 (CS); also elsewhere on the board
GSR_CS: U10.5 (CS); also elsewhere on the board
MOSI: U6.6 (SI), U7.3 (U/D), U8.3 (U/D), U10.6 (SI); also elsewhere on the board
unnamed: R38.2, U9.2 (RG)
unnamed: R38.1, U9.3 (RG)
unnamed: C30.2, C36.2, R36.1, U9.4 (+IN)
unnamed: C36.1, C43.1, R50.2, U9.1 (-IN)
unnamed: R42.1, U9.7 (OUT)
unnamed: C35.1, R42.2, U10.2 (CH0)
unnamed: R61.2, U12.2 (RG)
unnamed: R61.1, U12.3 (RG)
unnamed: C38.1, C52.1, R63.2, U12.1 (-IN)
unnamed: C37.2, C38.2, R44.1, U12.4 (+IN)
unnamed: R54.1, U12.7 (OUT)
unnamed: C47.1, R54.2, U6.2 (CH0)
unnamed: R53.2, U12.6 (REF)
unnamed: R34.2, U6.1 (VOUT)
unnamed: R43.2, R44.2, R48.1, U8.5 (W)
unnamed: CN8.2, CN10.3
unnamed: R35.1, R36.2, R37.2, U7.5 (W)
unnamed: R49.2, U10.1 (VOUT)
unnamed: R40.2, U9.6 (REF)
SCK: U6.7 (SCK), U10.7 (SCK); also elsewhere on the board
TMP+: CN10.4, R60.2, R63.1
TMPOF_CS: U8.4 (CS); also elsewhere on the board
TMP_CS: U6.5 (CS); also elsewhere on the board

Notes on the sheet:
EXTERNAL
10K NTC THERMISTOR
GSR RESISTANCE
INTERNAL
KEYPAD
MCP4012T-503E/CH
ESD Protection of Human Body
Low Pass Filter
G = 1 + ( 49.4Kohm / Rg )
RC not yet picked
Rg = Infinity -> G=1
Bulk Cap

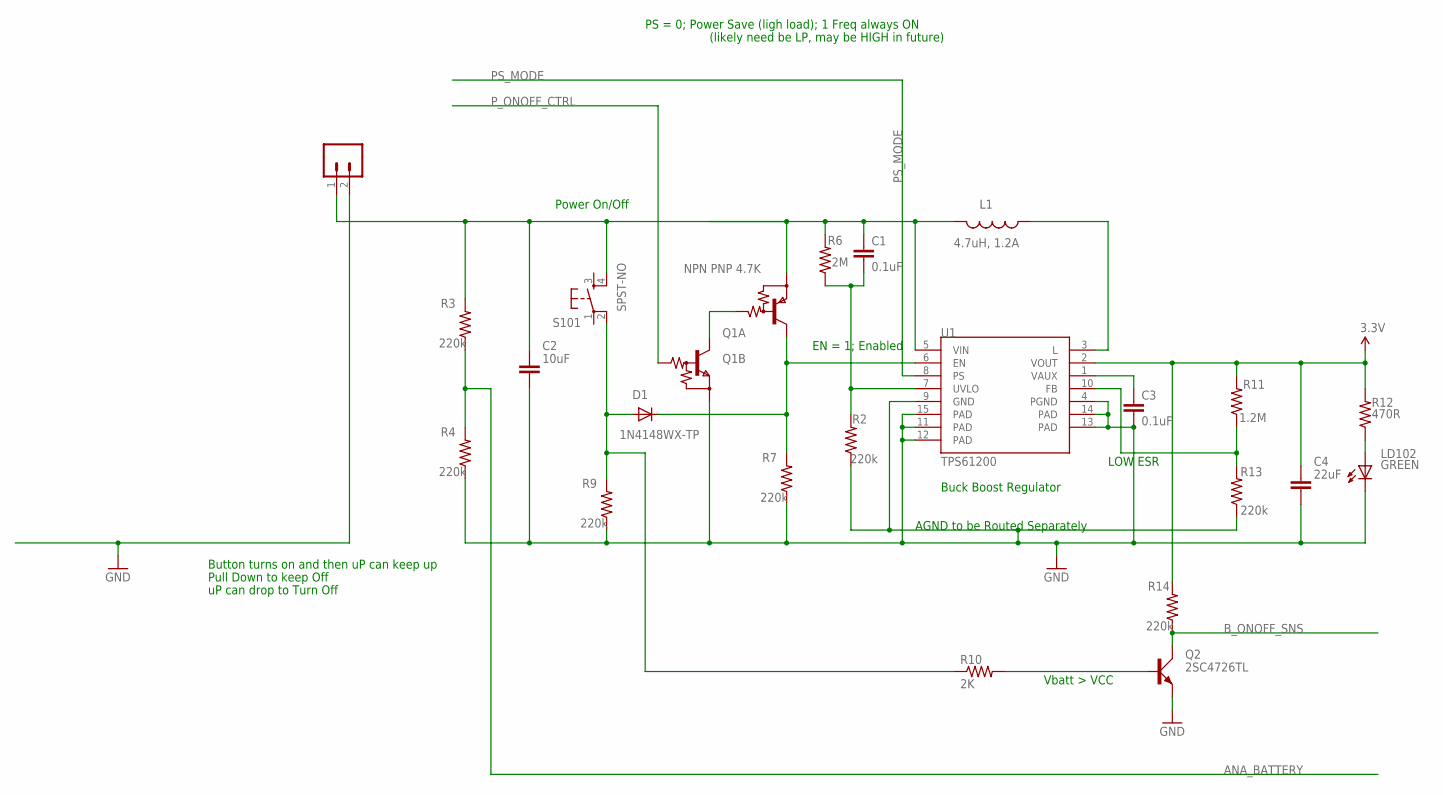
[picture p8: schematic biofeedback_2560_3V.sch, sheet 4]

Parts:
C1, C3: 0.1uF; C0603; PARTNO CC0603KRX7R7BB104
C2: 10uF; C0603; PARTNO C1608X5R1A106M
C4: 22uF; C0603; PARTNO 250R14W224KV4T
CN1: CONN HEADER PH TOP 2POS 2MM; 1X02; PARTNO B2B-PH-K-S(LF)(SN)
D1: 1N4148WX-TP; SOD323-R; PARTNO 1N4148WX-TP
L1: 4.7uH, 1.2A; CDRH2D09; PARTNO CDRH2D09NP-4R7MC
LD102: GREEN; CHIP-LED0805; PARTNO LG R971-KN-1-0-20-R18
Q1: NPN PNP 4.7K; SOT-23-6; PARTNO DMG264060R
Q2: 2SC4726TL; EMT3; PARTNO MMBT3904TT1G
R2, R3, R4, R7, R9, R13, R14: 220k; R0603; PARTNO RC0603JR-07220KL
R6: 2M; R0603; PARTNO RC0603JR-072ML
R10: 2K; R0603; PARTNO RC0603JR-072KL
R11: 1.2M; R0603; PARTNO CRCW04021M20FKED
R12: 470R; R0603; PARTNO RC0603JR-07470RL
S101: SPST-NO; TACTILE_SWITCH_SMD_6MM_SQ; PARTNO TL3301PF160QG
U1: TPS61200; QFN-10_PAD; PARTNO TPS61200DRCT

Connections:
3.3V: C4.1, R11.2, R12.2, R14.2, U1.2 (VOUT); also elsewhere on the board
ANA_BATTERY: R3.1, R4.2; also elsewhere on the board
B_ONOFF_SNS: Q2.C, R14.1; also elsewhere on the board
FB: R11.1, R13.2, U1.10 (FB)
GND: C2.2, C3.2, C4.2, CN1.2, LD102.C, Q1.1 (E), Q2.E, R2.1, R4.1, R7.1, R9.1, R13.1, U1.4 (PGND), U1.9 (GND), U1.11 (PAD), U1.12 (PAD), U1.13 (PAD), U1.14 (PAD), U1.15 (PAD); also elsewhere on the board
unnamed: LD102.A, R12.1
unnamed: Q1.5 (B), Q1.6 (C)
unnamed: L1.P$1 (1), U1.3 (L)
unnamed: C3.1, U1.1 (VAUX)
unnamed: D1.C, Q1.3 (C), R7.2, U1.6 (EN)
unnamed: D1.A, R9.2, R10.1, S101.2
unnamed: Q2.B, R10.2
PS_MODE: U1.8 (PS); also elsewhere on the board
P_ONOFF_CTRL: Q1.2 (B); also elsewhere on the board
UVLO: C1.2, R2.2, R6.1, U1.7 (UVLO)
VIN: C1.1, C2.1, CN1.1, L1.P$2 (2), Q1.4 (E), R3.2, R6.2, S101.4, U1.5 (VIN)

Notes on the sheet:
Buck Boost Regulator
AGND to be Routed Separately
Power On/Off
PS = 0; Power Save (ligh load); 1 Freq always ON
EN = 1; Enabled
Pull Down to keep Off
Button turns on and then uP can keep up
(likely need be LP, may be HIGH in future)
uP can drop to Turn Off
Vbatt > VCC
LOW ESR

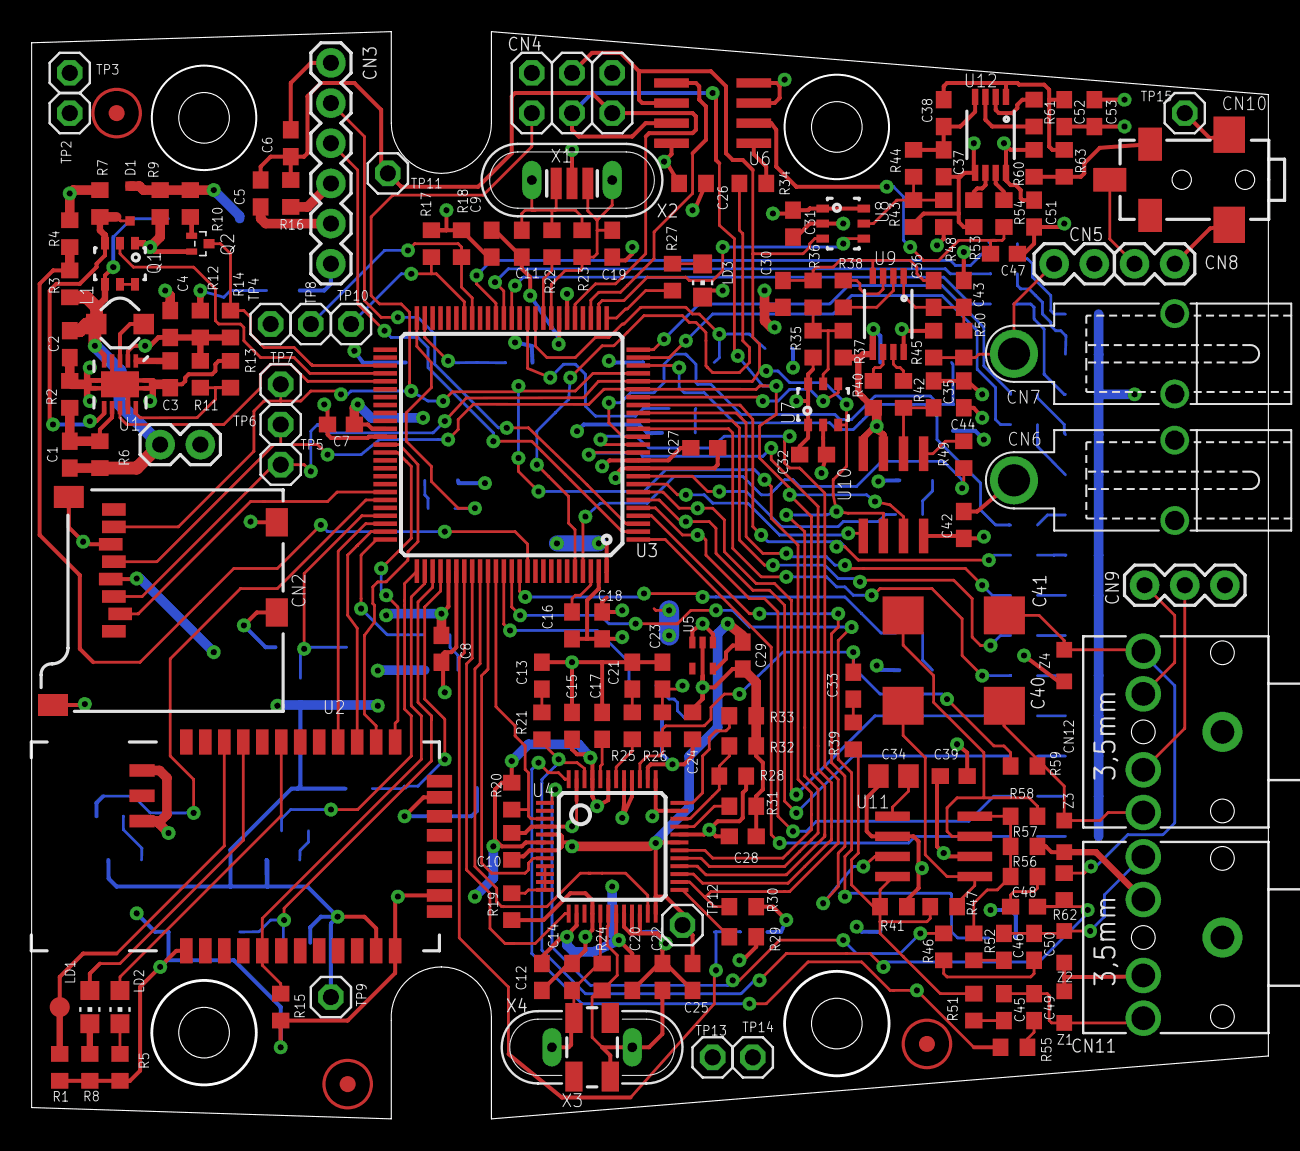
[picture p9: board biofeedback_2560_3V.brd from above]

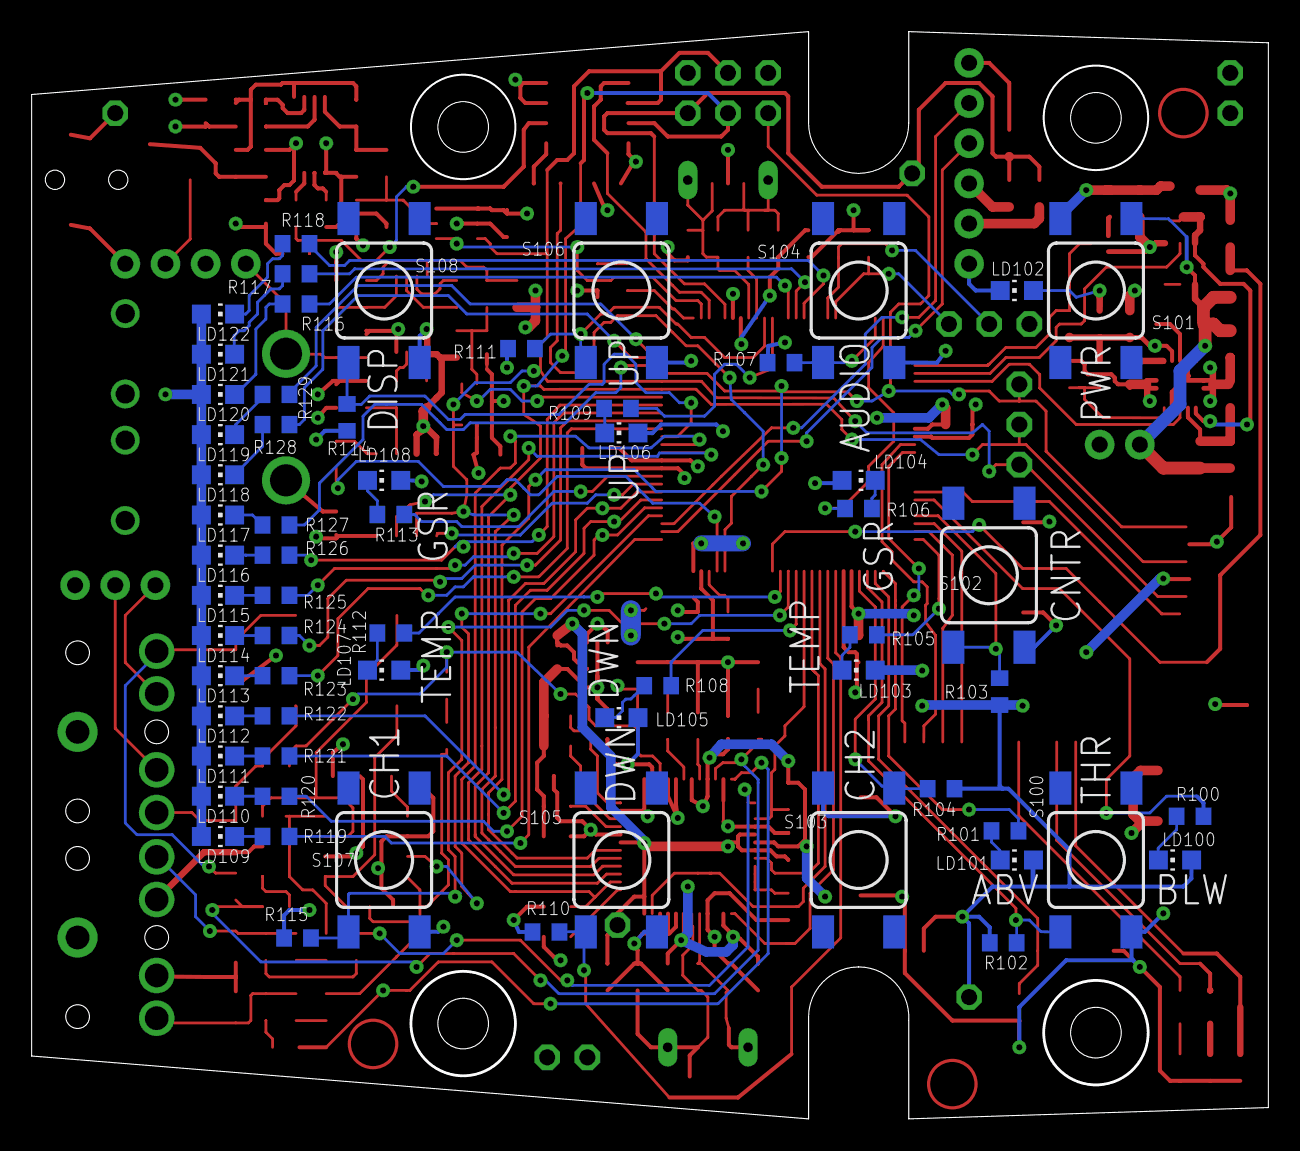
[picture p10: board biofeedback_2560_3V.brd from below]

Board: 4 copper layers, 78.2 x 68.7 mm, 235 parts (62 on the bottom side), 162 nets.
