mpflaga/biofeedback_2560_3V-eagle/(commit log)

2012-07-17 Initial Commit from what was built
    [biofeedback.brd, biofeedback.sch]
2013-08-01 renamed eagle files to match boards.txt biofeedback-mega:biofeedback_2560_3V
    [biofeedback_2560_3V.brd, biofeedback_2560_3V.sch]
2013-08-06 Added PDF of schematic
